anwarbernard/Voiture/README.md

# Projet Arduino Polytech Nice PEIP2 (Anwar BERNARD G1 / Quentin CHILLAT SHN3) 
Ce projet est un projet avec Arduino. Notre objectif est de créer une voiture commandé avec la gestuelle de la main de l'utilisateur.
