anwarbernard/Voiture/Rapports de Séance/Quentin CHILLAT/15 février/Rapport de Séance du 15 février.docx

Rapport de Séance du 15 février

Objectifs de la séance :

1. Déterminer le matériel nécessaire pour la séance
2. Fixer le pont en H sur la PCB
3. Câbler tout le système sur la plaque PCB

Déroulement de la séance :

1. Définition du matériel nécessaire pour la séance

Pour nous lancer correctement dans la séance, j’ai tout d’abord effectué un bref inventaire du matériel nécessaire au bon déroulement de la séance du jour. La séance du jour consiste à continuer l’amélioration de notre système en supprimant les câble souple en passant à un système avec une plaque PCB et une carte Arduino Nano. Aujourd’hui nous devons fixer le pont en H, souder tout le calage nécessaire au système (alimentation + module). C’est pourquoi nous avons eu besoin de :

- La plaque PCB avec l’avancement de la dernière séance.
- Visserie et entretoise
- Câbles pour PCB

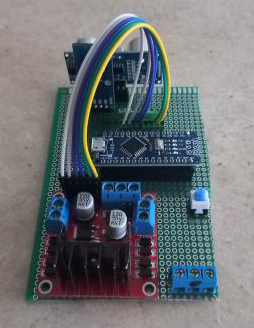
[picture p22: figure]
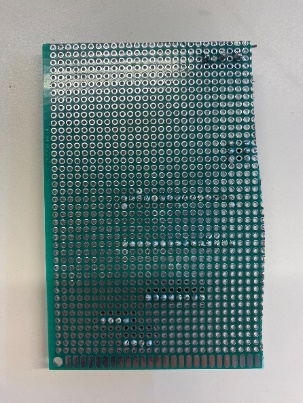
[picture p23: figure]
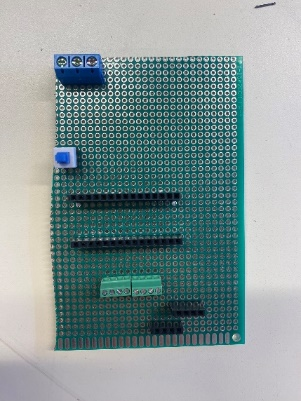
[picture p24: figure]
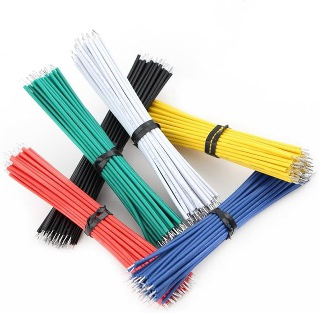
[picture p25: figure]
easyhaha 26AWG 7.8cm Fly Jumper câble Plaque de prototypage étamé PCB câble de Soudure 1007-26AWG Fils conducteurs en étain connecteur Fil Bricolage (Size : Blue 50PCS) : Amazon.fr: Bricolage
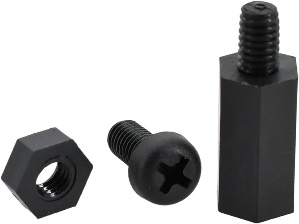
[picture p26: figure]
M2 M2.5 M3 M4 Nylon carte mère entretoise PCB Support carte de Circuit imprimé colonne Support piliers entretoise plastique vis hexagonale boulon (Color : 15mm (30Set), Size : M2.5 (Thread 6mm)) :

2. Fixation du pont en H sur la PCB

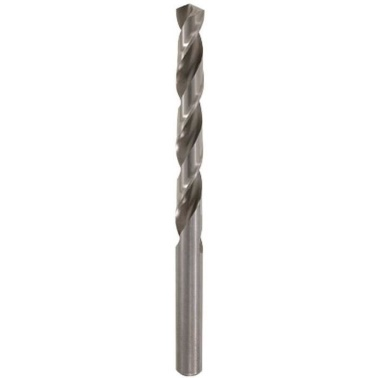
[picture p27: figure]
Foret HSS Tecn'x D: 3 mm lot de 2 - Cdiscount Bricolage
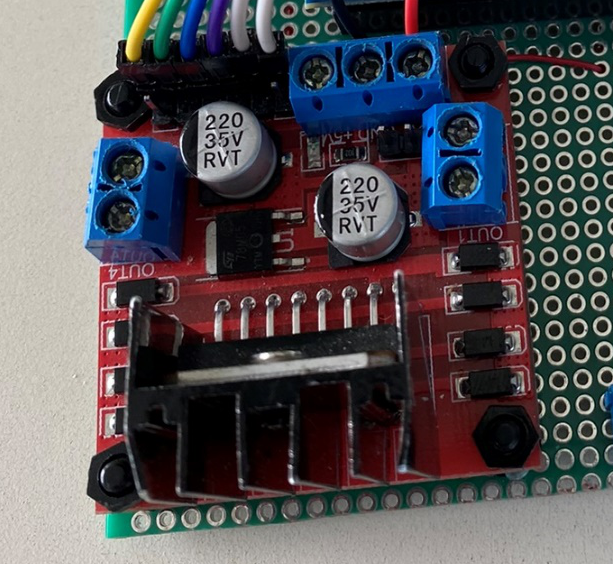
[picture p28: figure]

Pour fixer le pont en H sur notre plaque PCB, j’ai percé 4 trous avec un foret de 3mm pour faire passer la visserie qui permet de fixer le pont en H sur ses 4 coins.

3. Soudage de tous les câbles du système.

Pour finalisé notre montage sur la PCB et donc faire fonctionner notre projet, il faut câbler tous les composants entre eux. Nous avons commencer par souder les câbles du bornier de l’alimentation au 12V du pont en H.

Puis nous avons câblé les modules externe à la carte Arduino Nano. Le travail a été facilité par notre positionnement des modules au préalable en face de leur I/O de la carte Arduino :

Module | Pin du Module | N° I/O Arduino Nano
Pont en H | ENA | 3 (~)
| IN1 | 4
| IN2 | 5
| IN3 | 6
| IN4 | 7
| ENB | 9 (~)
Capteur Ultra-Son | Trig | 10
| Echo | 11
HC-06 (Bluetooth) | RX | 12
| TX | 13

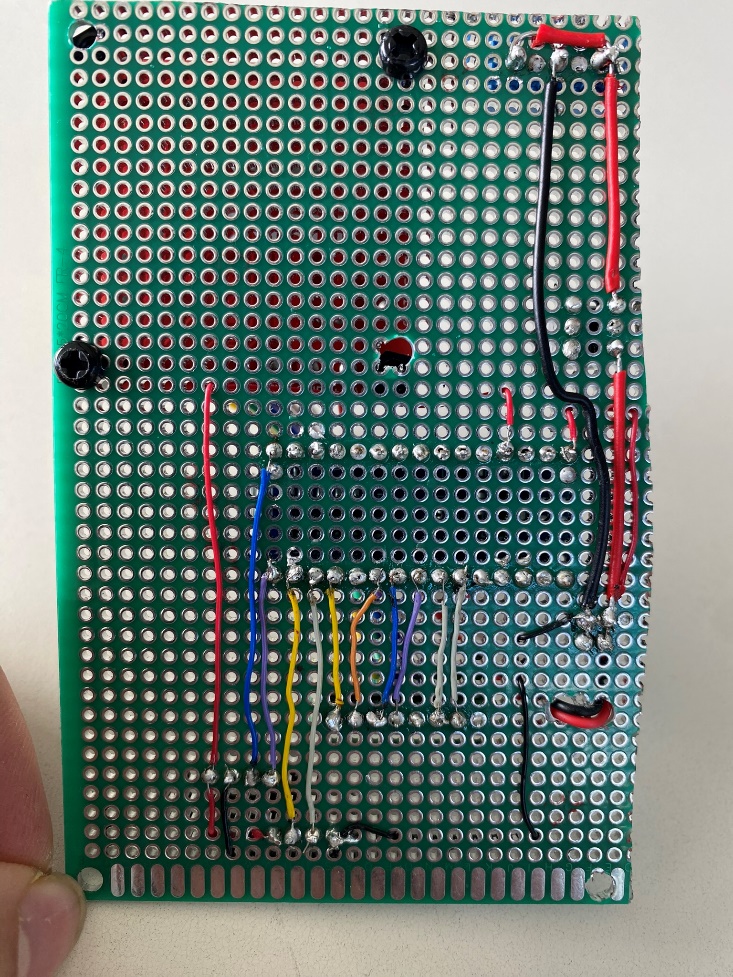
[picture p29: figure]

Vue de dessus :

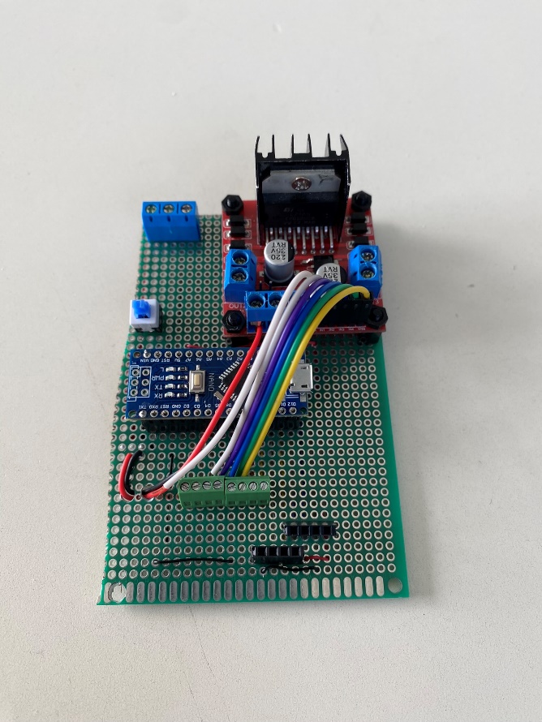
[picture p30: figure]

Pour la prochaine séance, nous devrons vérifier si tout notre câblage est correcte, puis connecter les moteurs au pont en H, puis fixer la plaque PCB au châssis de la voiture.

CHILLAT QuentinProjet ARDUINOPolytech-Nice SHN3
