anwarbernard/Voiture/Rapports projet hebdo Anwar Bernard/Rapport semaine1 Anwar BERNARD.pdf

## Projet Arduino Voiture robotisée & contrôlée par Bluetooth

Bernard Anwar (en collaboration avec Chillat Quentin)

Rapport Semaine 1 (le 15/12/2023)

Matériels utilisés

- Plaque Arduino.
- Châssis de voiture.
- 2 pneus de voiture.
- 1 roue universelle.
- 2 moteurs réducteurs TT de double axe.
- Module contrôleur de moteurs L298N.
- Interrupteur ON/OFF à 2 pins.
- Boîtier de batteries 4 piles AA.
- Fils.
- Vis et écrous.
- Accéléromètre

Schéma

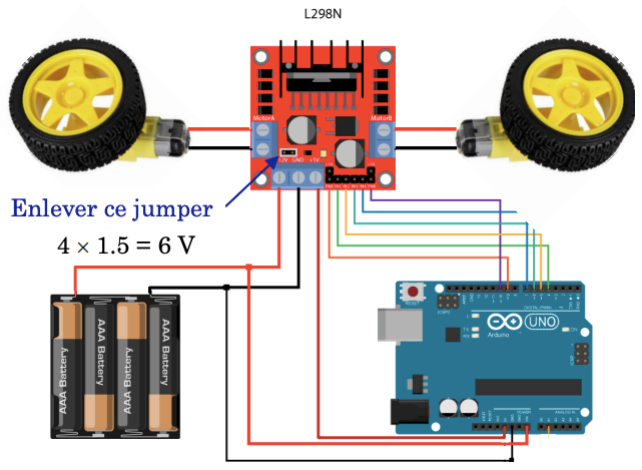
[picture p96: figure]

Désossage d’une ancienne voiture Arduino

Récupération de la partie inférieure d’une ancienne voiture à deux niveaux et désossage.

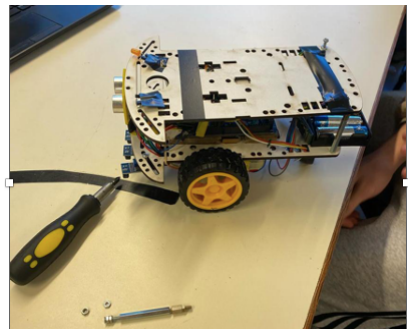
[picture p97: figure]
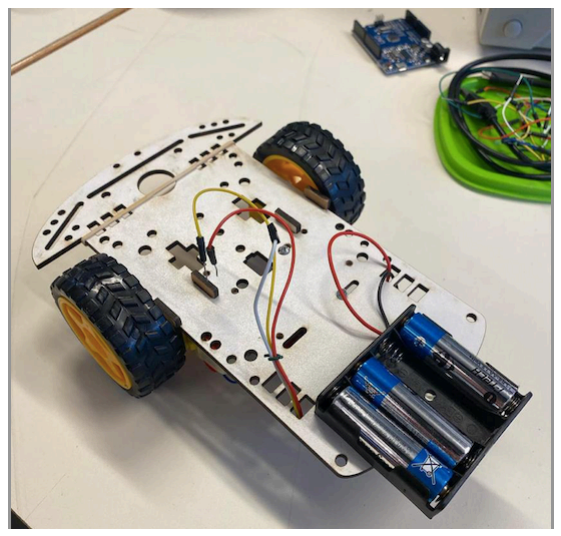
[picture p98: figure]

Assemblage
1) Assemblage déjà réalisé :
a. Fixage des moteurs au châssis
b. Installation de la roue universelle et du boîtier des batteries.
2) Assemblage réalisé
a. Fixage de la plaque Arduino à l’avant du châssis

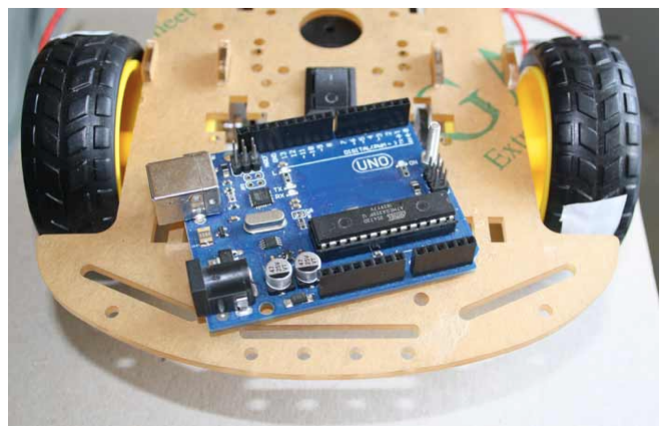
[picture p99: figure]

b. Installation du module L298N à l’arrière du châssis.
| Câblage des moteurs avec leurs pins correspondant du module

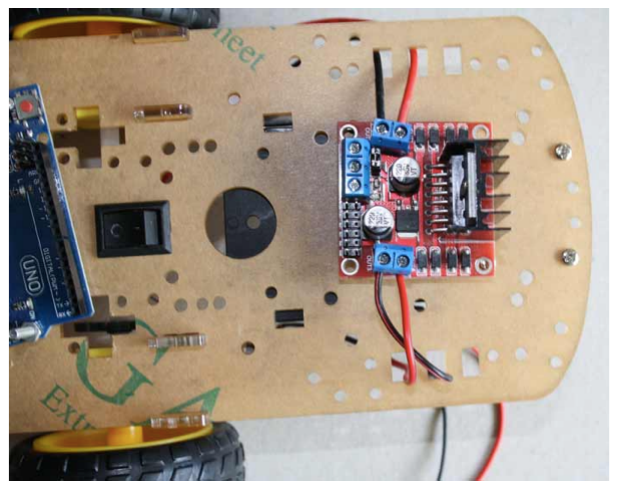
[picture p100: figure]

c. Connexion de la plaque Arduino avec le module L298N.
| Reliage des pins :
- ENAè pin 9 gère la vitesse de rotation
- ENBè pin 10 gère la vitesse de rotation
- IN1 è pin 4
- IN2 è pin 5
- IN3 è pin 6
- IN4 è pin 7
d. Fixage de l’interrupteur

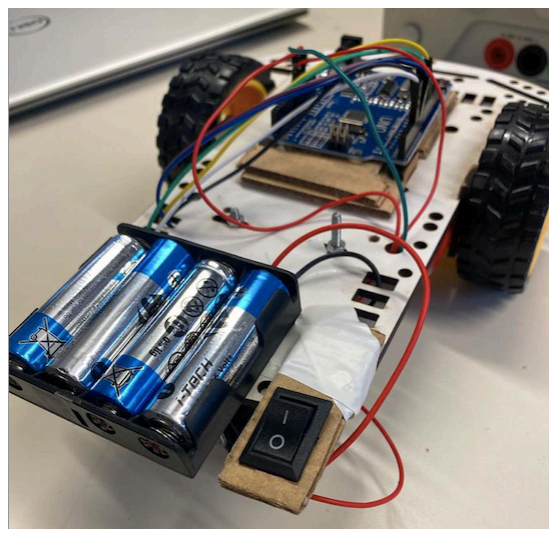
[picture p101: figure]
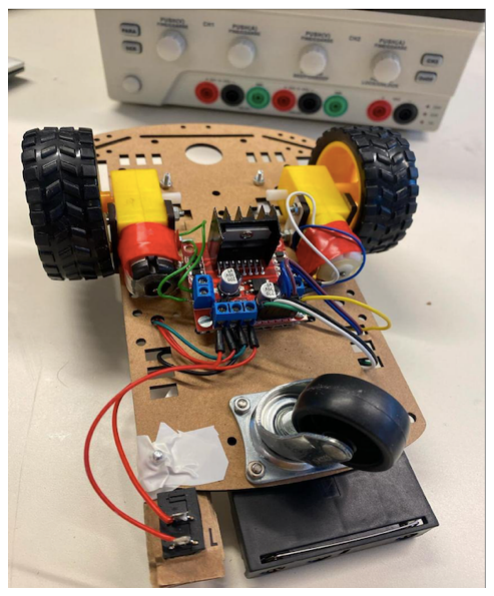
[picture p102: figure]
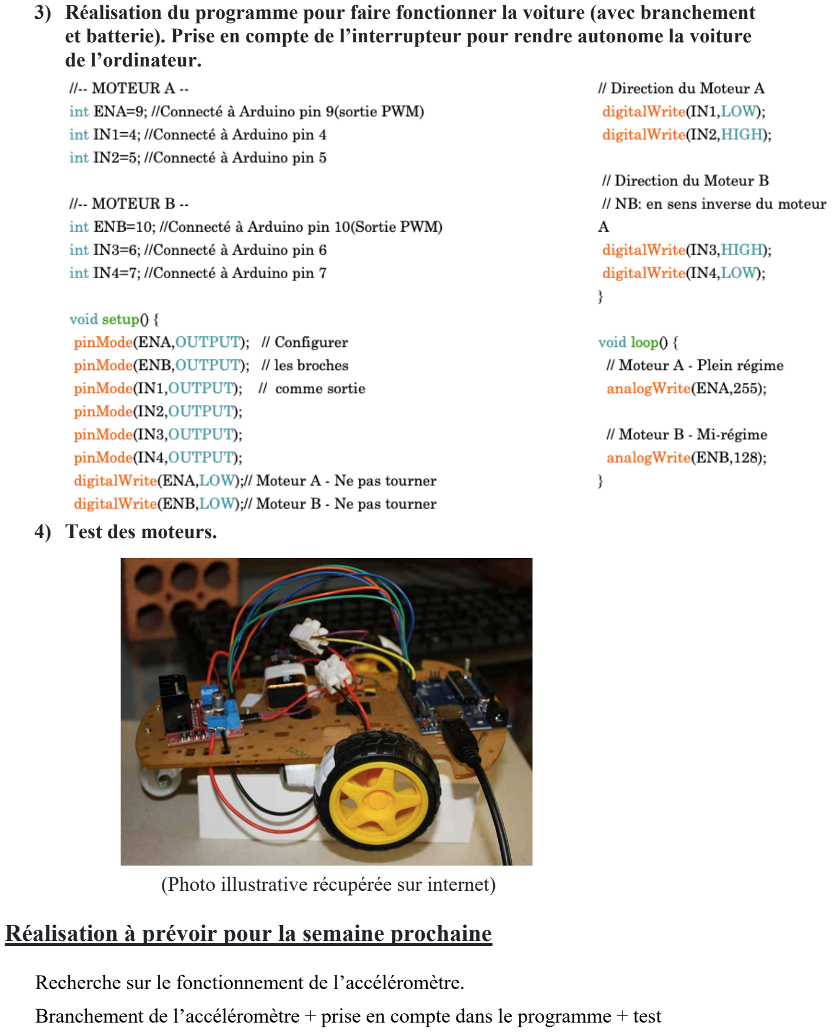
[picture p103: page 3]

3) Réalisation du programme pour faire fonctionner la voiture (avec branchement
| et batterie). Prise en compte de l’interrupteur pour rendre autonome la voiture
| de l’ordinateur.
4) Test des moteurs.

(Photo illustrative récupérée sur internet)

Réalisation à prévoir pour la semaine prochaine

Recherche sur le fonctionnement de l’accéléromètre.
Branchement de l’accéléromètre + prise en compte dans le programme + test
