anwarbernard/Voiture/Projet Arduino PEIP.pdf

# PROJET ARDUINO PEIP

BERNARD Anwar | CHILLAT Quentin
Une Voiture commandée en Bluetooth, | avec un gant !

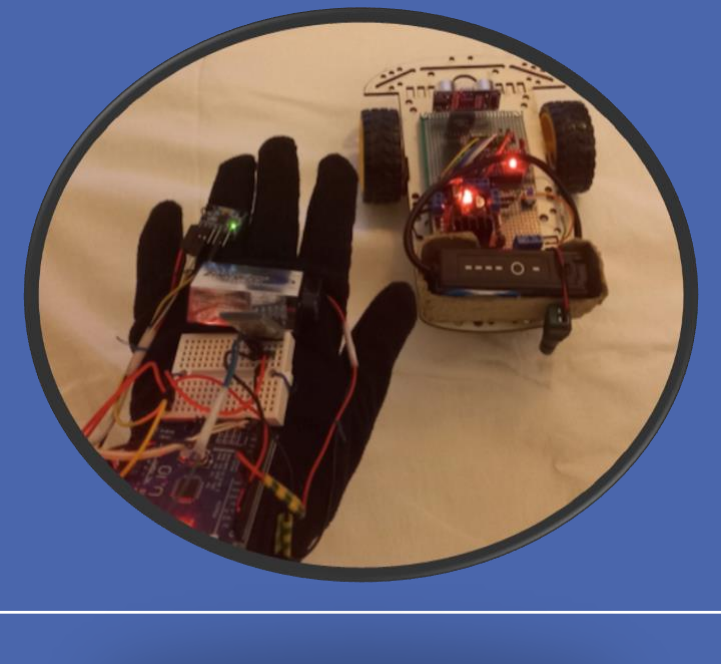
[picture p104: figure]
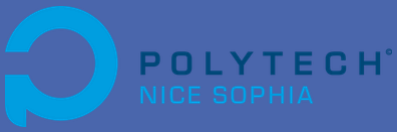
[picture p105: figure]

# Introduction

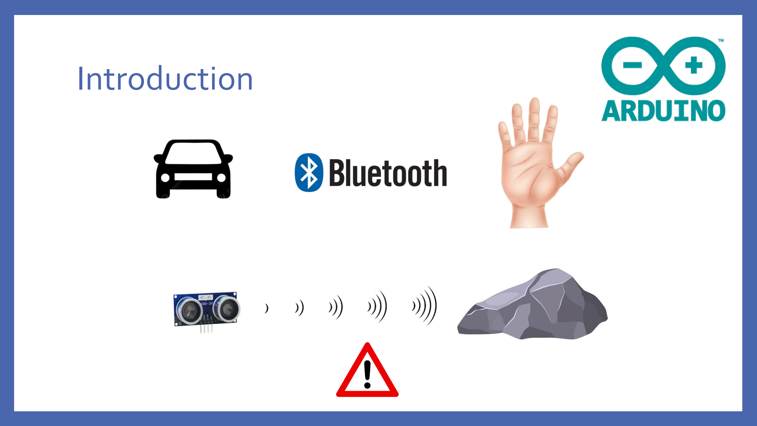
[picture p106: page 2]

# Pourquoi ce projet ?

- Souvenir d’enfance ? | Voiture télécommandée
- Communication sans fils ? | Bluetooth
- Idée originale ? | Avec le mouvement de la main

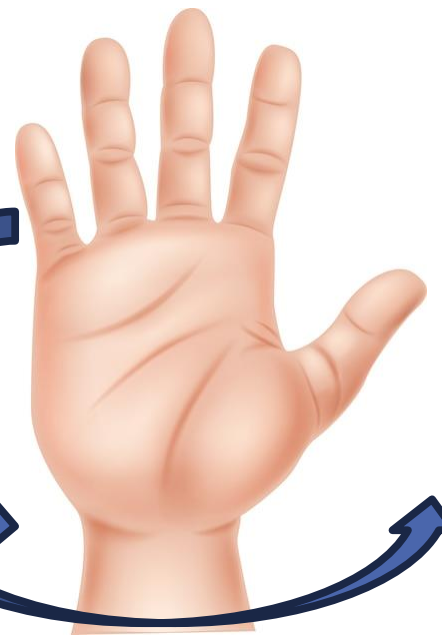
[picture p107: figure]

# Comment ça fonctionne ?

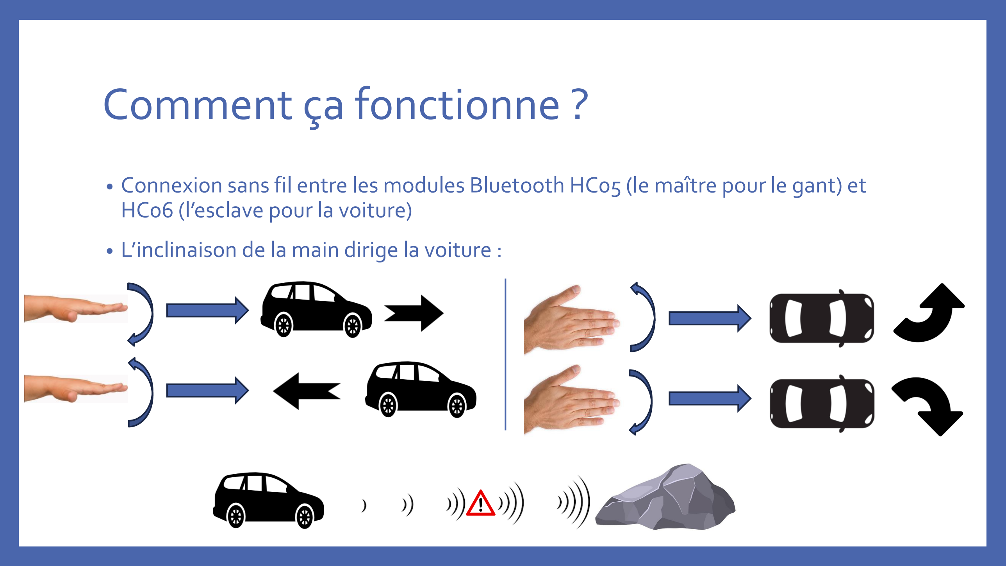
[picture p108: page 4]

### - Connexion sans fil entre les modules Bluetooth HC05 (le maître pour le gant) et HC06 (l’esclave pour la voiture)

### - L’inclinaison de la main dirige la voiture :

# Planning

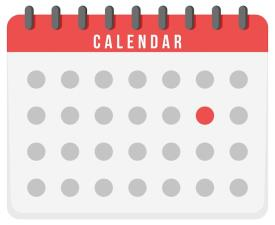
[picture p109: figure]

N° Semaine | Tâches effectuées
1 | Inventaire du matériel nécessaire / Confection de la voiture
2 | Récupérer les mouvements de la main sous forme de donnés à transmettre / Choisir le type de communication sans fils (RF ou Bluetooth)
3 | Etablir la communication sans fils entre le gant et la voiture
4 | Recherche et résolution de bug / Optimisation des programmes
5 | Ajout système évitement d’obstacle
6 | Remplacement du système Arduino de la voiture par des branchements PCB (1)
7 | Remplacement du système Arduino de la voiture par des branchements PCB (2)
8 | Résolution de bug / Finalisation du projet

# Le gant !

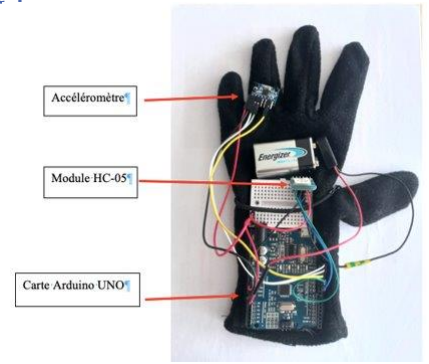
[picture p110: figure]

# La voiture !

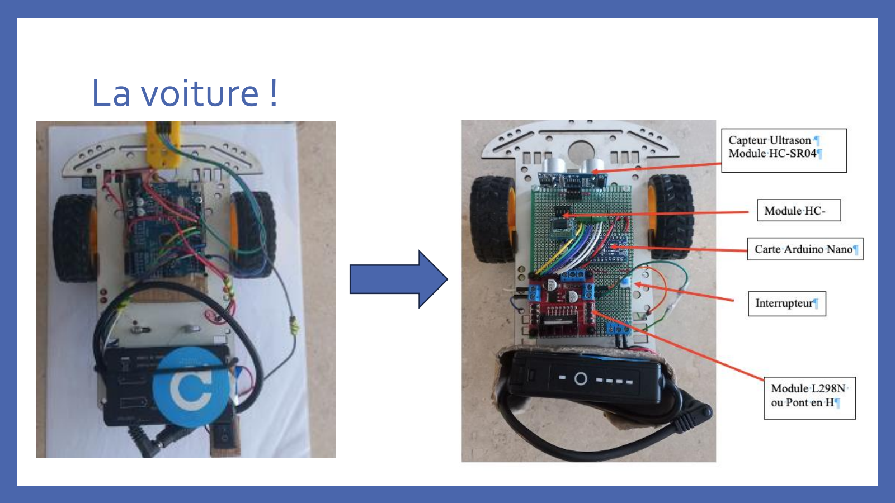
[picture p111: page 7]

# Les programmes

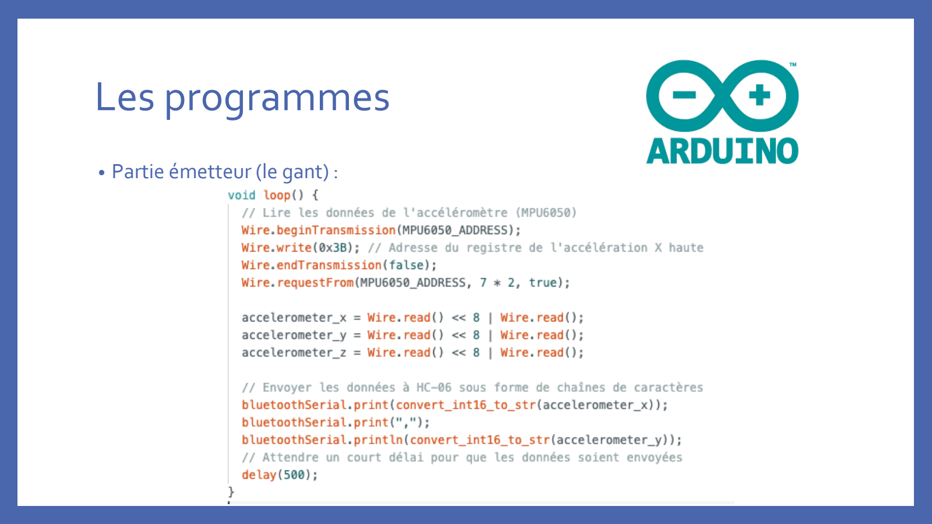
[picture p112: page 8]

### - Partie émetteur (le gant) :

# Les programmes

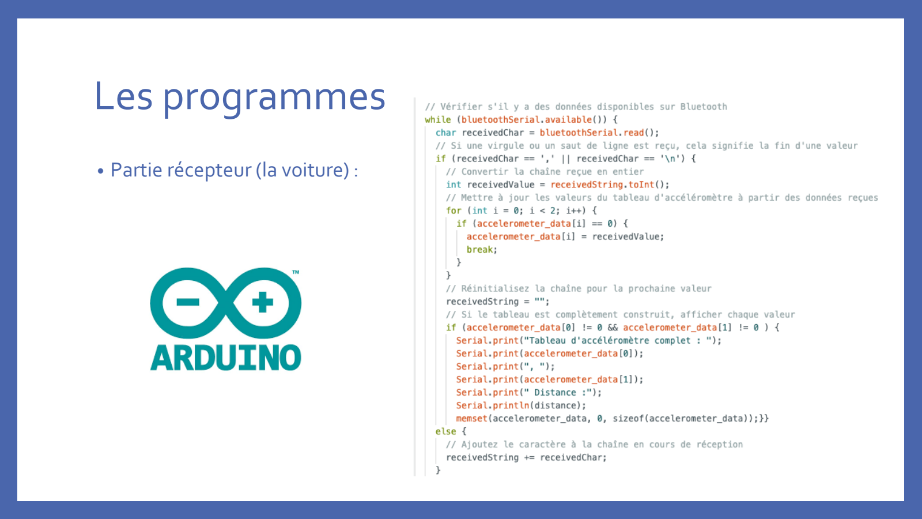
[picture p113: page 9]

### - Partie récepteur (la voiture) :

# PLACE À LA DÉMONSTRATION

# MERCI DE NOUS AVOIR ÉCOUTÉ !
