anwarbernard/Voiture/(commit log)

2023-12-15 Cahier des charges
2023-12-15 Create Rapport de Séance Quentin CHILLAT
2023-12-16 Rename Rapport projet Arduino Anwar BERNARD.pdf to Rapport Séance n°1 Anwar BERNARD.pdf
2023-12-21 Rename Rapports de Séance/Quentin CHILLAT/Rapport de Séance du 15 décembre.pdf to Rapports de Séance/Quentin CHILLAT/15 décembre/Rapport de Séance du 15 décembre.pdf
